monsurhillas/Temperature-monitoring-system-using-Microcontroller-PIC-16f877a/README.md

# Temperature-monitoring-system-using-Microcontroller-PIC-16f877a
 A microcontroller based project where PIC 16f877a was used. this system can sense a temperature and display it on the lcd display. also it has a buzzer system which starts buzzing when the temperature crosses a fixed value. This project was done in the Course CSE331 in North South University. SID: 1721911042
