monsurhillas/Temperature-monitoring-system-using-Microcontroller-PIC-16f877a/(list of files, drawings)

Other design files:
src/331softwaresimulation.pdsprj
